leumasdam/clipper-popolnik/stl/clipper-preform-dock.stl

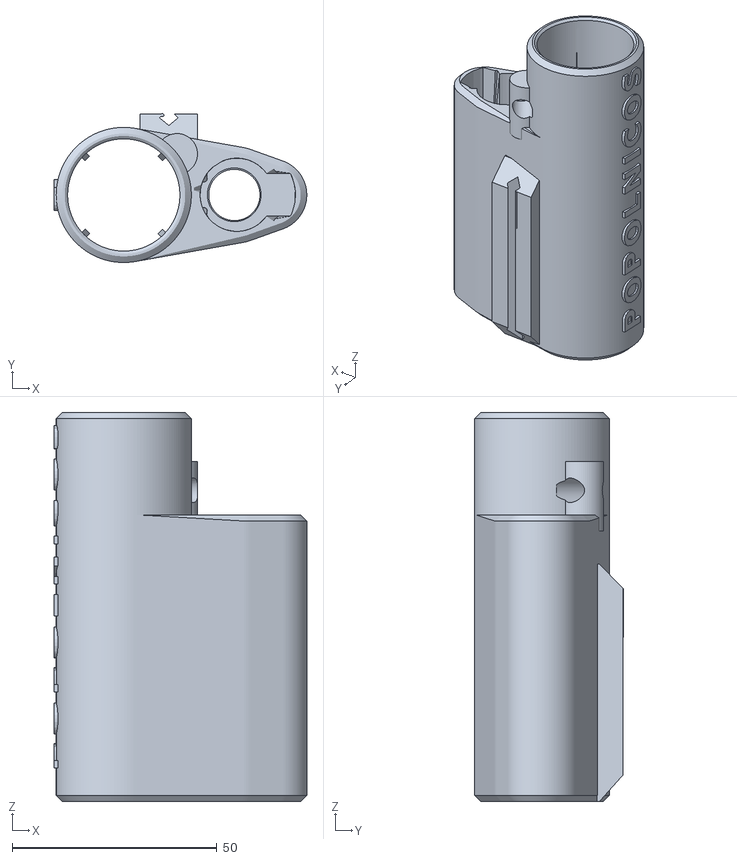
[picture p1: CAD file, 2026-07-24]
stl/clipper-preform-dock.stl
61.7 x 36.4 x 95.0
