leumasdam/clipper-popolnik/stl/clipper-holster-koncept.stl

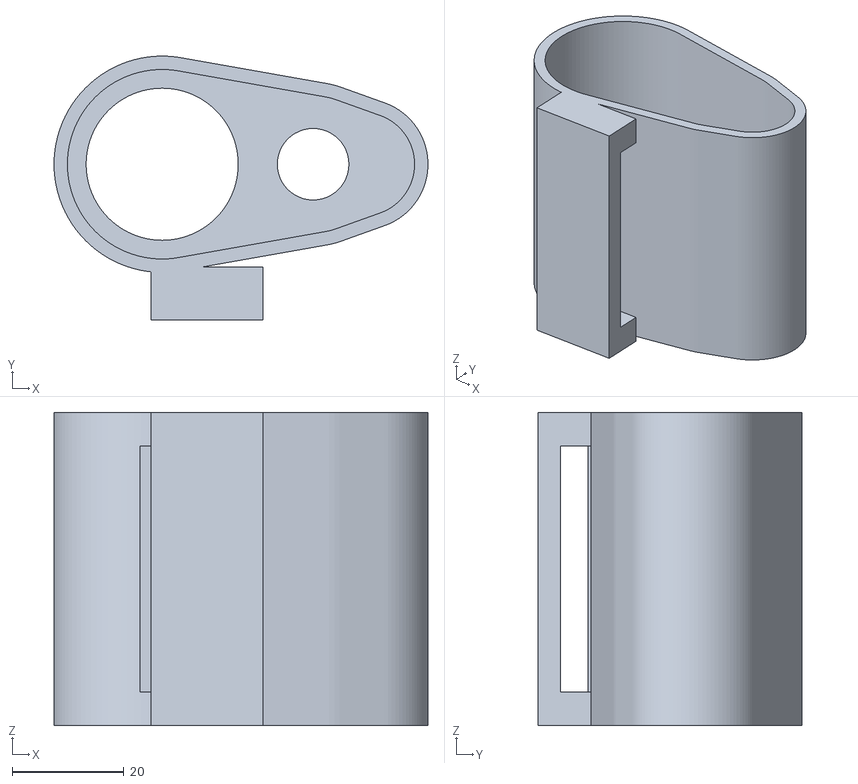
[picture p2: CAD file, 2026-07-24]
stl/clipper-holster-koncept.stl
66.9 x 47.2 x 56.0
