leumasdam/clipper-popolnik/stl/clipper-belt-clip.stl

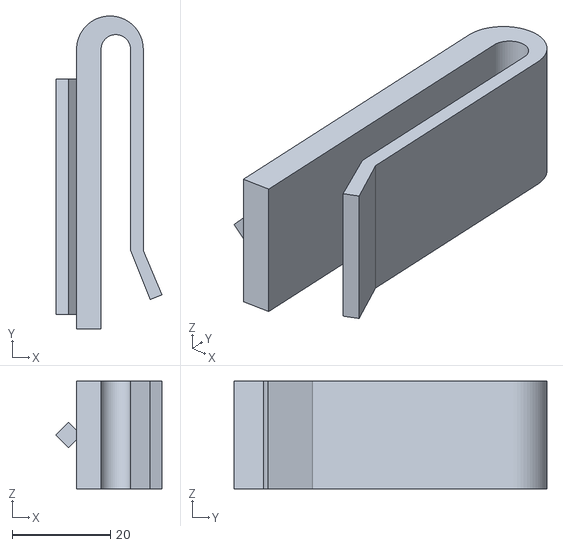
[picture p3: CAD file, 2026-07-24]
stl/clipper-belt-clip.stl
21.6 x 63.8 x 22.0
