leumasdam/clipper-popolnik/stl/clipper-pocket-ashtray.stl

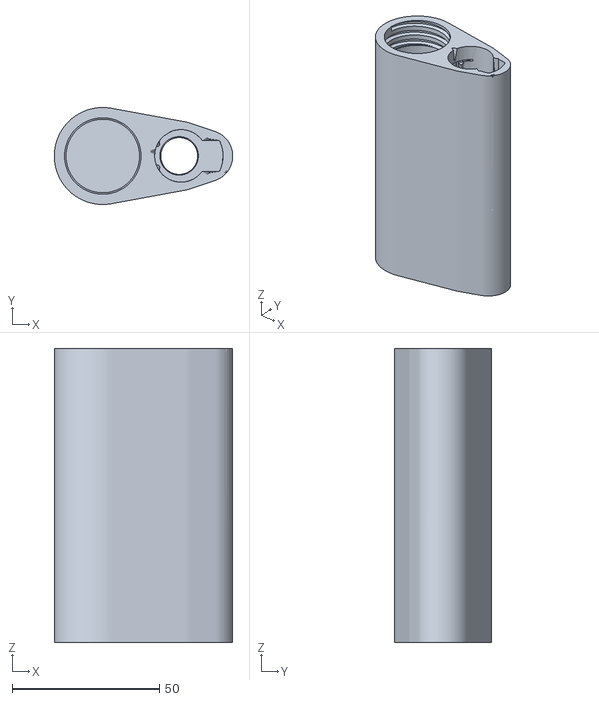
[picture p4: CAD file, 2026-07-23]
stl/clipper-pocket-ashtray.stl
60.7 x 33.0 x 100.0
