leumasdam/clipper-popolnik/stl/clipper-pocket-ashtray-cap.stl

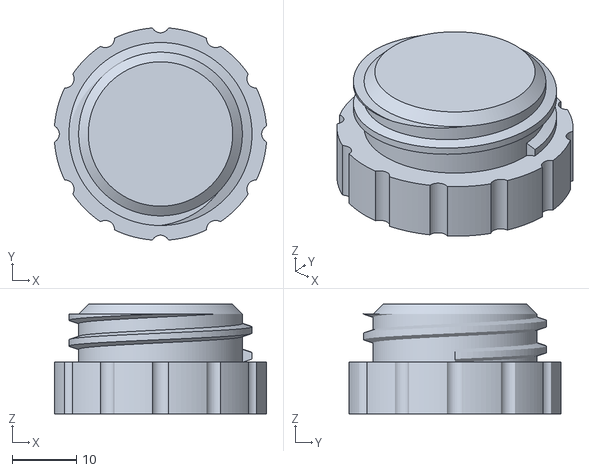
[picture p5: CAD file, 2026-07-23]
stl/clipper-pocket-ashtray-cap.stl
32.9 x 32.9 x 17.0
