leumasdam/clipper-popolnik/(commit log)

2026-07-23 Clipper popolnik - interaktivny 3D nahlad + STL
    [clipper-pocket-ashtray-cap.stl, clipper-pocket-ashtray.stl, clipper-preform-dock.stl]
2026-07-23 v2 po prvom prototype: volnejsie clipper vrecko, collet + priechodne dno
    - clipper keyhole negativ zvacseny o ~0,25 mm radialne (da sa vytiahnut)
    - objimka docku zuzena na Ø26,5, vnutri 4 pruzne prsty (waist Ø21,5),
    ktore zovru telo preformy - drzi napevno, ale da sa vymenit
    - dno priechodne Ø25,2: gulaty spodok preformy sa prestrci von
    - viewer aktualizovany na v2 geometriu, preforma 103 mm pod nakruzkom
    [clipper-pocket-ashtray.stl, clipper-preform-dock.stl]
2026-07-23 v3: belt clip — zvisly dovetail rail na chrbte docku + samostatny klip
    - rail (krk 8 / spicka 10, z=30..86, 45° nabeh dole) tlaceny nastojato s telom
    - klip (62x16 mm, belt gap 2,5, flare spicka) tlaceny nalezato = vrstvy
    v rovine ohybu; rybinovy slot s dorazom, nasuva sa zhora, vaha docku
    ho tlaci do dorazu
    - viewer: klip namontovany na docku, download link na clipper-belt-clip.stl
    [clipper-belt-clip.stl, clipper-preform-dock.stl]
2026-07-23 v4: collet nahradeny klinovymi rebrami (tlacova robustnost)
    - collet padal pri tlaci (volna geometria v hlbokej dutine) - zruseny
    - objimka je priechodna rura O25,6 bez dna, spodok preformy trci von
    - 4 zvisle klinove rebra (O24,2 dole -> flush hore) zrastene so stenou:
    preforma sa sama zaklini, toleruje telo O24,3-25,3, eject tlakom zdola
    - kalibracia z prototypu: hrdlo ~24 mm, telo ~24,5-25 (dome sa zasekol
    v tlacenej diere ~24,5)
    [clipper-preform-dock.stl]
2026-07-23 v5: kalibracia bore z troch vytlackov - telo preformy je ~26,5-26,8
    v4 bore 25,6 bol prilis maly (telo nevojde), hrdlo ~24 je uzsie nez telo.
    Bore O27,4, klinove rebra O25,9 dole -> flush hore.
    [clipper-preform-dock.stl]
2026-07-23 clipper vrecko +0,06 mm radialne (scale 1.037) - feedback z v5 testu
    [clipper-pocket-ashtray.stl, clipper-preform-dock.stl]
2026-07-23 v6: klin rebier prehlbeny na O25,0 dole (v5 kladla nulovy odpor)
    Telo preformy spresnene na ~25,5-25,8 (v4 bore 25,6 nevoslo, v5 rebra
    25,9 bez odporu). Tlac zaobluje spicky rebier o ~0,1-0,2.
    [clipper-preform-dock.stl]
2026-07-23 v7: belt clip presunuty na velku bocnu plochu + 45° dovetail profil
    - rail na y- bocnej ploche (stred x=10, z=6..59): dock pripnuty lezi
    naplocho pri tele, nie kolmo (feedback z v6)
    - profil railu/slotu zmeneny na 45° dovetail: slot v klipe sa tlaci
    bez plytkych mostikov (v6 robil spagety)
    - vole stiahnute na 0,2/stranu + pritlacny hrbolcek pred dorazom
    - klin rebier O25,0 z v6 bez zmeny
    [clipper-belt-clip.stl, clipper-preform-dock.stl]
2026-07-23 v7.1: sirsi klip (22 mm) a rail (krk 12 / spicka 16) pre stabilitu
    [clipper-belt-clip.stl, clipper-preform-dock.stl]
2026-07-23 v7.2: belt gap klipu 2,5 -> 4,0 mm (sadne aj na pas gati)
    [clipper-belt-clip.stl]
2026-07-23 v7.3: belt gap 6 mm + dlhsi flare - nasadzovanie takmer bez ohybu
    [clipper-belt-clip.stl]
2026-07-23 v7.4: clipper vrecko +0,04 mm radialne (scale 1.042), dock aj variant A
    [clipper-pocket-ashtray.stl, clipper-preform-dock.stl]
2026-07-23 v7.5: klin rebier zmiernieny na O25,4 dole + clipper vrecko 1.047
    - rebra: 25,0 nedovolili dotlacit preformu na doraz; 25,4 = stred medzi
    25,9 (nulovy odpor) a 25,0 (prilis)
    - clipper vrecko: tretie mikro-uvolnenie, +0,04 mm radialne
    [clipper-pocket-ashtray.stl, clipper-preform-dock.stl]
2026-07-23 v8: detaily - chamfer hran, C-prstenec na vrchnak, lanyard usko, POPOLNIKOS
    - 45° zrazenie 1,5 mm spodneho obvodu + hornych hran lalokov
    - parkovaci C-prstenec na vrchnak z flase (vnutro O30,3) na y+ ploche
    - lanyard usko s dierou O4,5 dole vpredu
    - reliefny napis POPOLNIKOS (0,6 mm) zvisle na y- ploche vedla railu
    [clipper-preform-dock.stl]
2026-07-23 v8.1: C-prstenec zruseny, lanyard ako flush tunel v sedle medzi lobmi
    - prstenec na vrchnak odstraneny (feedback: netreba)
    - lanyard usko nahradene priechodnym tunelom O4,6 (teardrop strop)
    vnutri sedla @ y=12, z=64 - snurka sa prevlecie, silueta cista
    [clipper-preform-dock.stl]
2026-07-23 v8.2: fix chybajucich O v napise (klasifikacia obrys/diera cez parnost vnorenia)
    [clipper-preform-dock.stl]
2026-07-23 v8.3: lanyard = diera skrz rail; vacsi napis s rozstupom na prednej ploche
    - tunel v sedle zruseny (otvaral sa do plochy ako ryha)
    - diera cez U klipu zavrhnuta (pri voleni om viseni sa clip moze vysunut)
    - lanyard: O3,5 diera skrz vrch railu - drzi priamo dock, klip ju prekryje
    - POPOLNIKOS: cap 5,8 (z 5,2), jednotny pitch buniek (ziadne zlievanie),
    presunuty na prednu y+ plochu (pri noseni vidno)
    [clipper-preform-dock.stl]
2026-07-23 v8.4: POPOLNIKOS na vysokej valcovej ploche objimky, cap 7,2 mm
    [clipper-preform-dock.stl]
2026-07-23 v8.6: snap zamok klipu (gulicka na raile + jamka v slote), lanyard cez U klipu
    - diera v raile aj spodny tunel zrusene (rail kryje klip / dole = hore nohami)
    - klip po dosadnuti zacvakne: nevysunie sa pri viseni, zlozenie pevnym tahom
    - snurka sa viaze cez medzeru klipu okolo U ohybu - hore, popolnik visi rovno
    [clipper-belt-clip.stl, clipper-preform-dock.stl]
2026-07-23 v8.7: karabinove usko v sedle, POPOLNICOS z profilu, snap zamok zruseny
    - usko: volne stojaca plutvicka na hornej doske (7x3,6x12,5), diera O5,5,
    v podoryse nepresahuje obrys, hore = popolnik visi rovno
    - napis POPOLNICOS (bez dlzna, s C) na zadnej ploche valca, cap 7,2
    - snap zamok vrateny spat na overeny treci hrbolcek (ziadne riziko)
    [clipper-belt-clip.stl, clipper-preform-dock.stl]
2026-07-23 v8.8: karabinovy lug zabudovany do ovalu objimky (r4,5 nalevok + diera O5)
    - lug zrasteny so stenou objimky aj doskou, tangencialna diera O5,
    1,2 mm steny k vrtaniu (ziadny prieraz), oba konce volne
    - nic nestoji samostatne, silueta v podoryse bez zmeny
    [clipper-preform-dock.stl]
2026-07-24 v9: diamantovy klip system (45° steny = tlacitelnost) + rebra O25,24
    - slot v klipe 3x zlyhal na odkvapkavani -> klip je plny (nic sa nemosti),
    na ploche ma diamantovy rail (stvorec 45°, vsetky steny presne 45°)
    - dock ma pad s vertikalnym diamantovym kanalom (strbina 2,6, diamant 6,4),
    doraz hore, trecie rebro v poslednych 12 mm
    - klin rebier O25,4 -> 25,24 (mikro pritiahnutie skumavky)
    [clipper-belt-clip.stl, clipper-preform-dock.stl]
2026-07-24 v9.1: prirodzeny kerning napisu (FT2Font advances + tracking 0,8) a novy variant Klip samostatne vo vieweri
    [clipper-preform-dock.stl]
2026-07-24 viewer: variant D - holster koncept (puzdro so sluckou + dock zasunuty)
    [clipper-holster-koncept.stl]
2026-07-24 holster koncept: slucka spravne horizontalne (tunel na opasok zboku, svetlost 44)
    [clipper-holster-koncept.stl]
2026-07-24 v9.2: lug diera O5 -> O6 na karabinu, lug zosilneny r4,5 -> r5
    [clipper-preform-dock.stl]
2026-07-24 v9.3: napis POPOLNICOS posunuty o 4 mm vyssie
    [clipper-preform-dock.stl]
2026-07-24 v9.4: rebra dole O25,24 -> O25,14 (druhy mikro-krok zovretia skumavky)
    [clipper-preform-dock.stl]
2026-07-24 v9.5: pad s kanalom presunuty na y+ stranu (k lugu); klip je symetricky, sedi bez uprav
    [clipper-preform-dock.stl]
